rabdulkarim/VELOS-R2/hardware/thrust_stand/thrust_stand_v1-Body.3mf

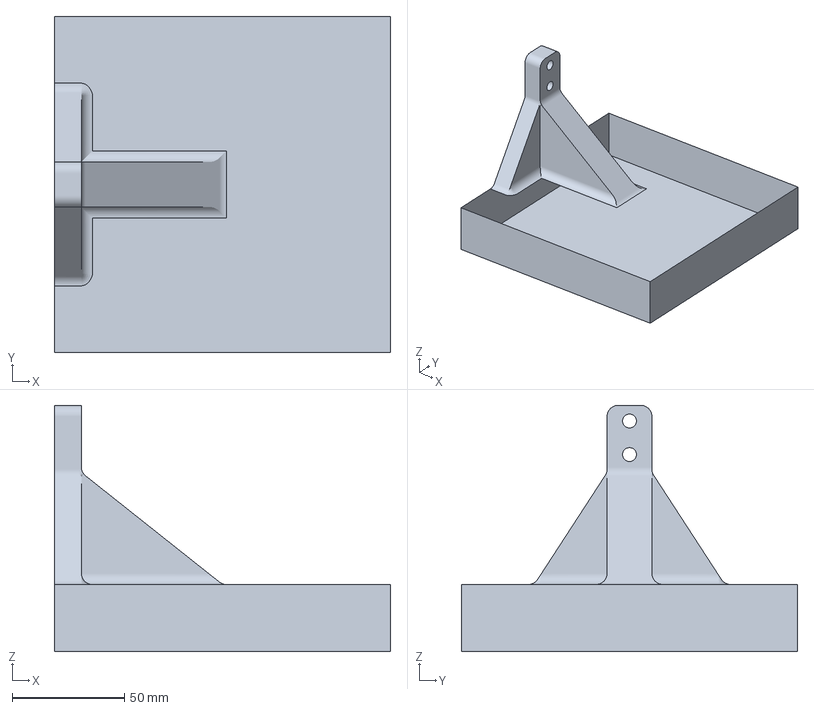
[picture p1: CAD file, 2026-07-31]
hardware/thrust_stand/thrust_stand_v1-Body.3mf
150.0 x 150.0 x 110.0 mm
