rabdulkarim/VELOS-R2/hardware/tvc_gimbal/v1.FCStd

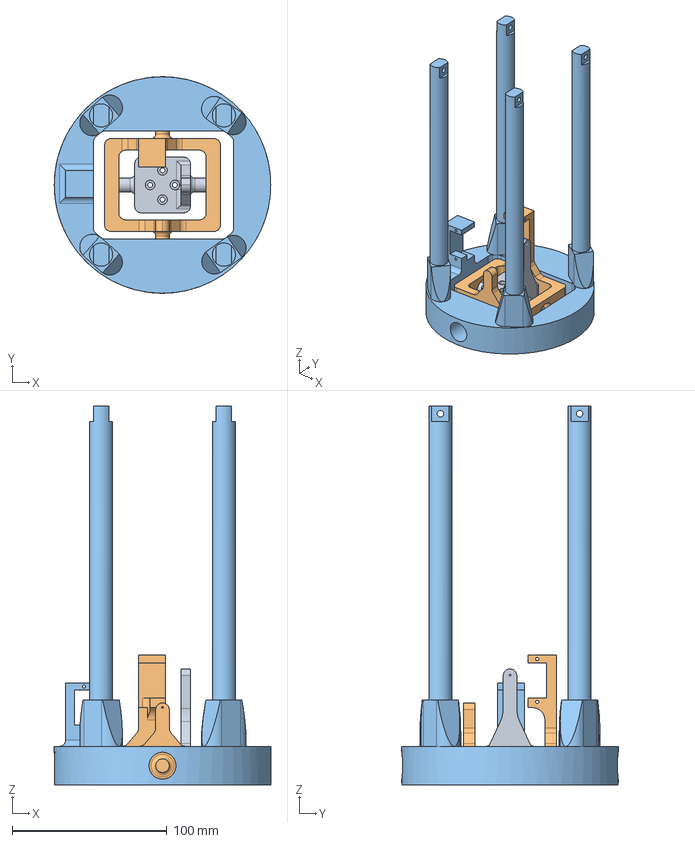
[picture p2: CAD file, 2026-08-03]
hardware/tvc_gimbal/v1.FCStd
140.0 x 140.0 x 245.0 mm
MotorMount
CenterRing
OuterRing
