rabdulkarim/VELOS-R2/hardware/thrust_stand/thrust_stand-Body.stl

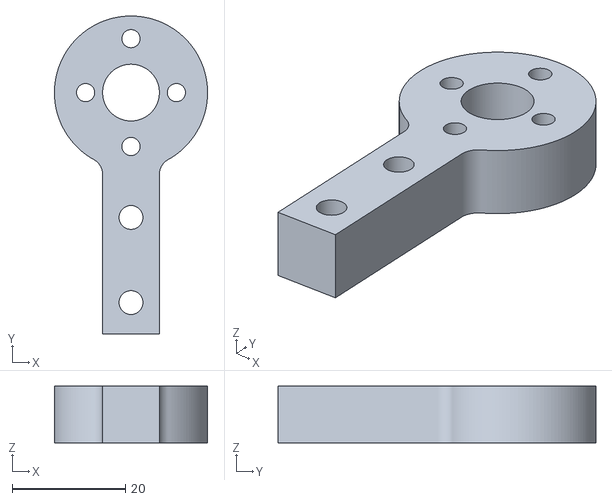
[picture p3: CAD file, 2026-06-29]
hardware/thrust_stand/thrust_stand-Body.stl
27.0 x 56.0 x 10.0
