rabdulkarim/VELOS-R2/(commit log)

2026-06-28 chore(hardware): add v1 static load cell motor mount mesh
    [thrust_stand.stl]
2026-06-29 chore(hardware): corrected the STL file, previous didn't display correctly in Cura
    [thrust_stand-Body.stl, thrust_stand.stl]
2026-07-27 (add-file): added the first version/prototype of TVC gimbal as a FreeCAD project file, includes 3 rings: outer ring secures 2 servo motors, center ring rotates on the x-axis, inner ring rotates on th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
    [v1.FCStd]
2026-07-28 feat: Complete TVC gimbal assembly with structural reinforcement
    - Added 220mm structural rods with triangular gussets for VTOL frame
    - Applied fillets to stress points and optimized clearance for servo arms
    TVC gimbal almost ready for print testing.
    [v1.FCStd]
2026-07-31 feat(hardware/thrust_stand): added thrust_stand-Body.3mf, STL file not displaying properly in Ultimaker-Cura.
    [thrust_stand_v1-Body.3mf]
2026-08-03 feat(hardware/tvc_gimbal): moved MotorMount servo from outer ring to center ring to eliminate servo horn stress and ensure metal pushrods dont warp or bend.
    [v1.FCStd]
2026-08-04 docs(DEVLOG.md): updated DEVLOG with recent mods and updates.
    Updated DEVLOG with recent project milestones and modifications, including finalization of motor mount designs, printing of thrust stand, and adjustments to servo placements and wiring.
